varmagokul6/Golf-Ball-Launcher/Documentation/Propulsion Sketch - Gokul Varma.pdf

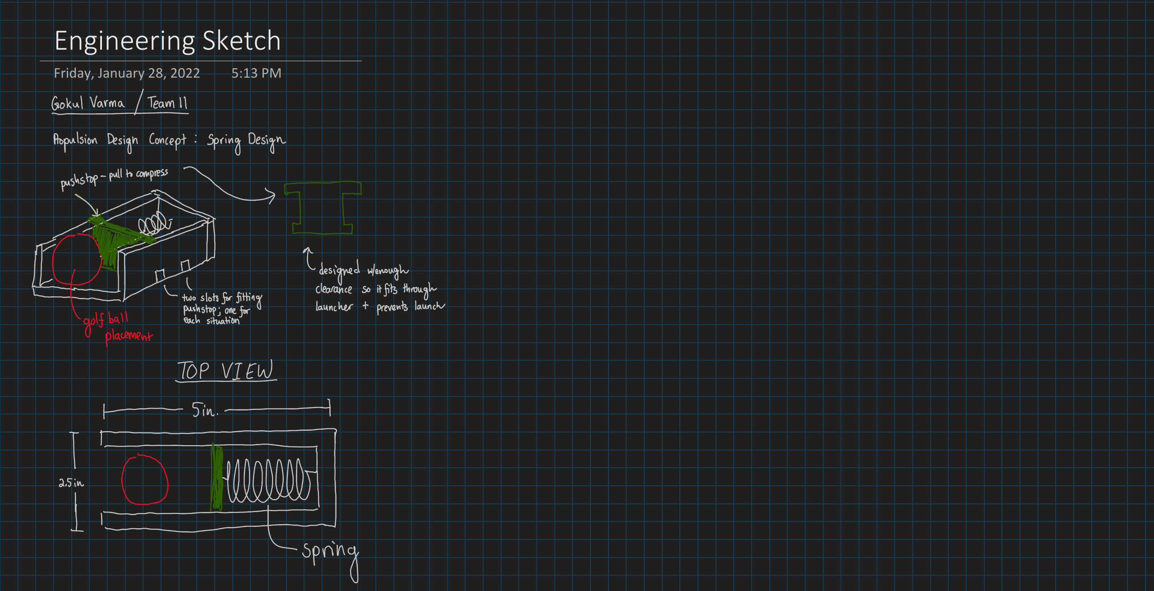
[picture p5: page 1]
