varmagokul6/Golf-Ball-Launcher/golf ball launcher.png

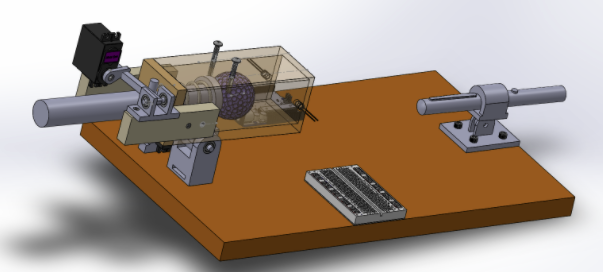
golf ball launcher.png
