varmagokul6/Golf-Ball-Launcher/images/finalprod.png

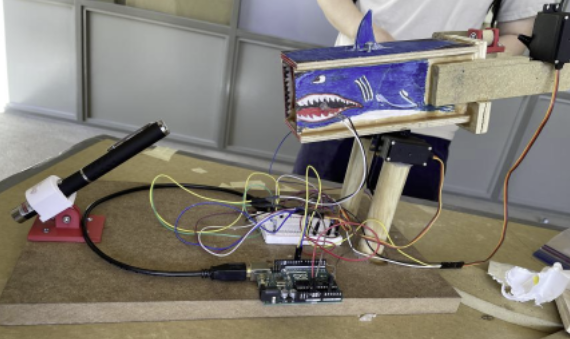
images/finalprod.png
