varmagokul6/Golf-Ball-Launcher/images/IMG_9626.jpg

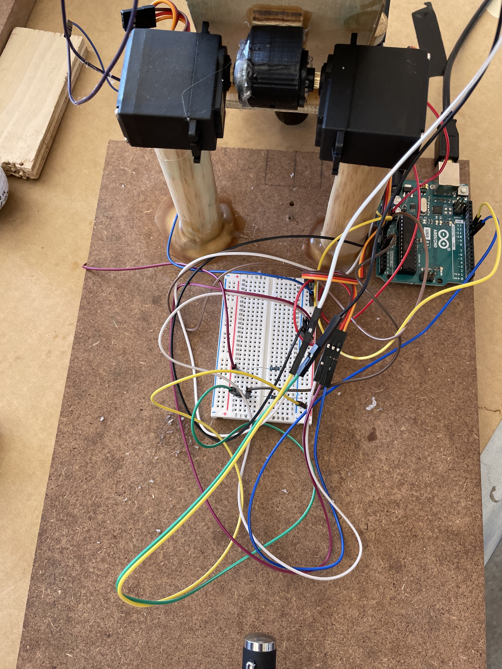
images/IMG_9626.jpg
