varmagokul6/Golf-Ball-Launcher/Documentation/Design Challenge_ Detailed Design Engineering Drawings and Manufacturing Files.pdf

## Detailed Design Engineering Drawings and Manufacturing Files

NOTE: All dimensions made in the engineering drawings are in inches unless stated otherwise

Pin:

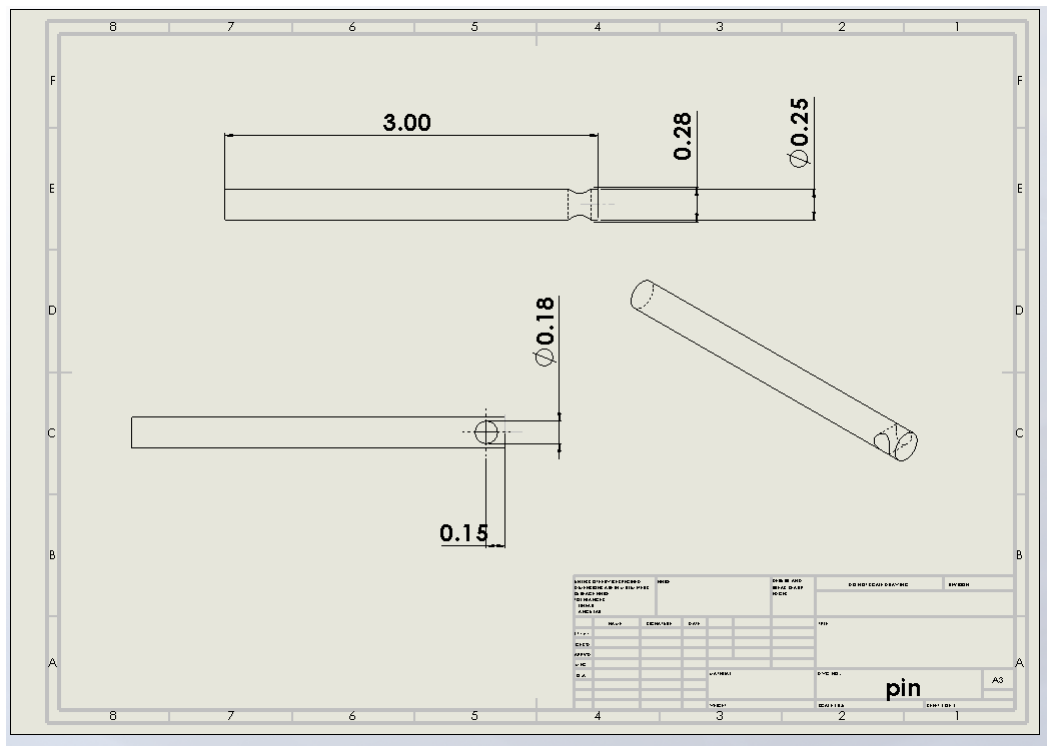
[picture p9: figure]

Pin Bearing:

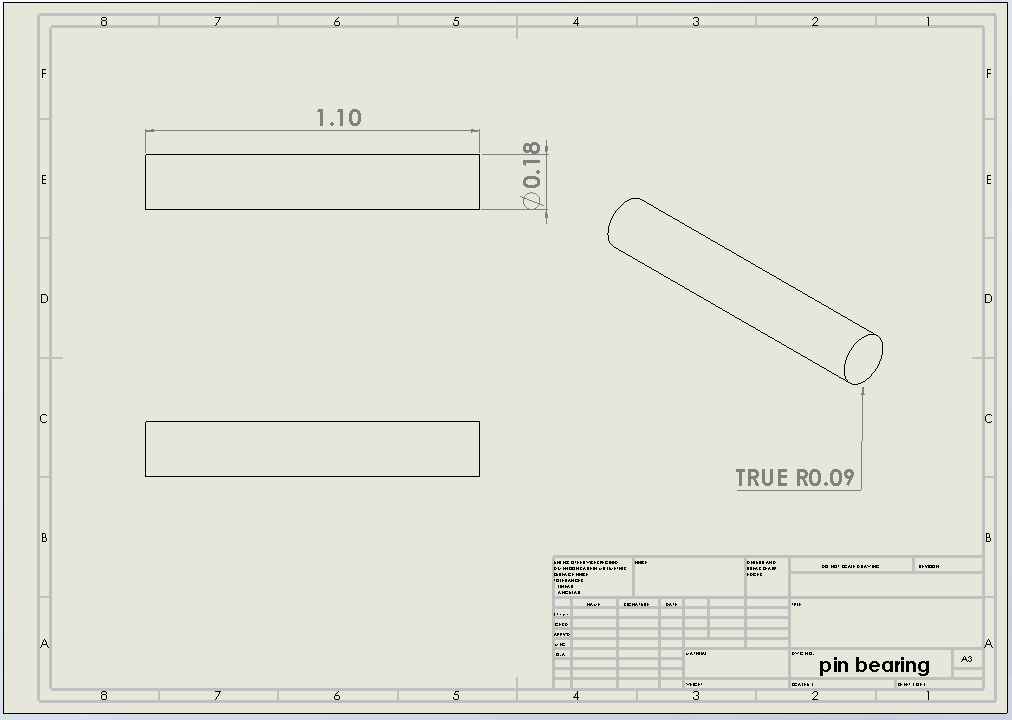
[picture p10: figure]

Plunger:

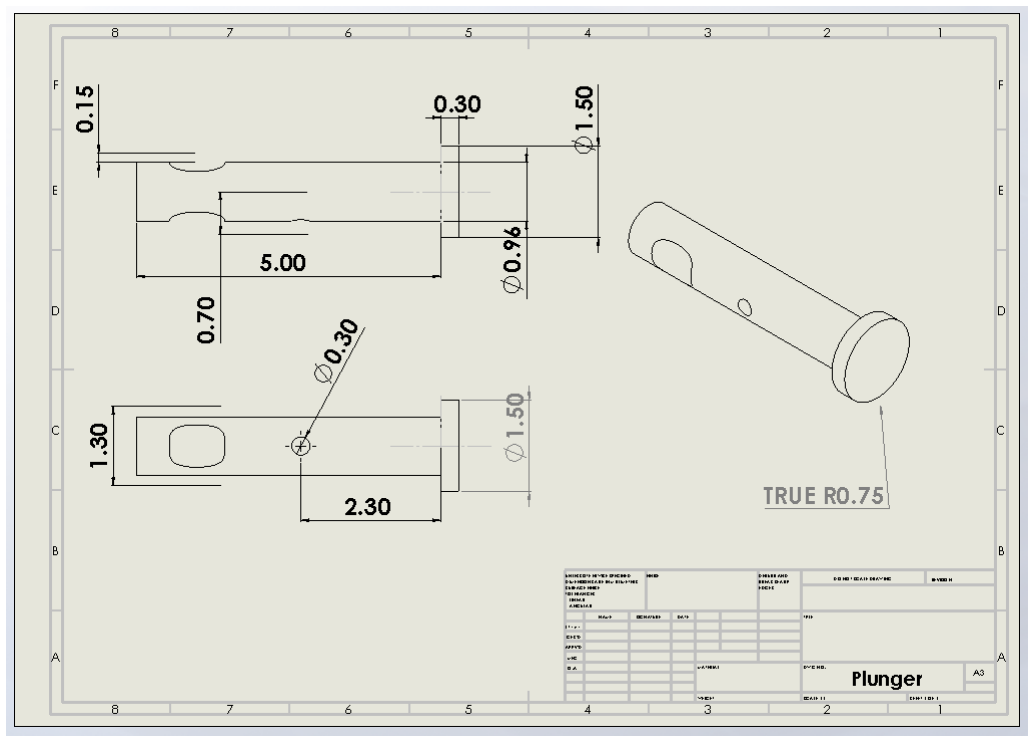
[picture p11: figure]

Plunger pin:

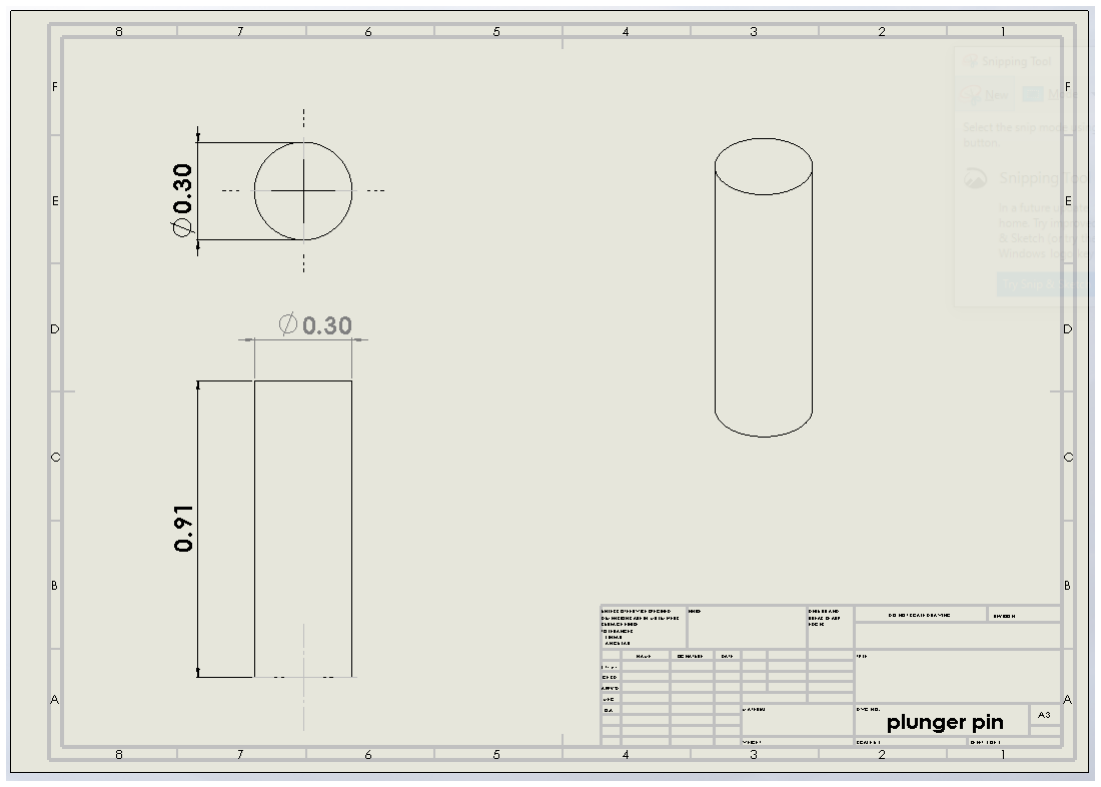
[picture p12: figure]

Laser Pivot:

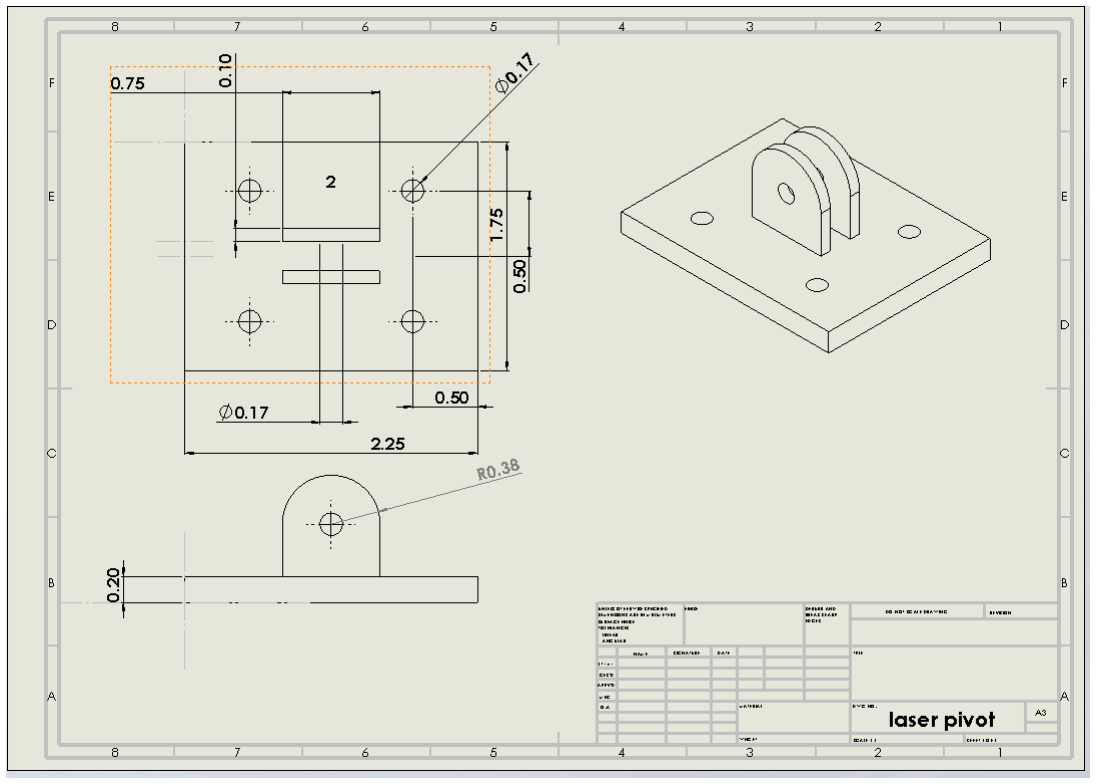
[picture p13: figure]

Laser Housing New 22:

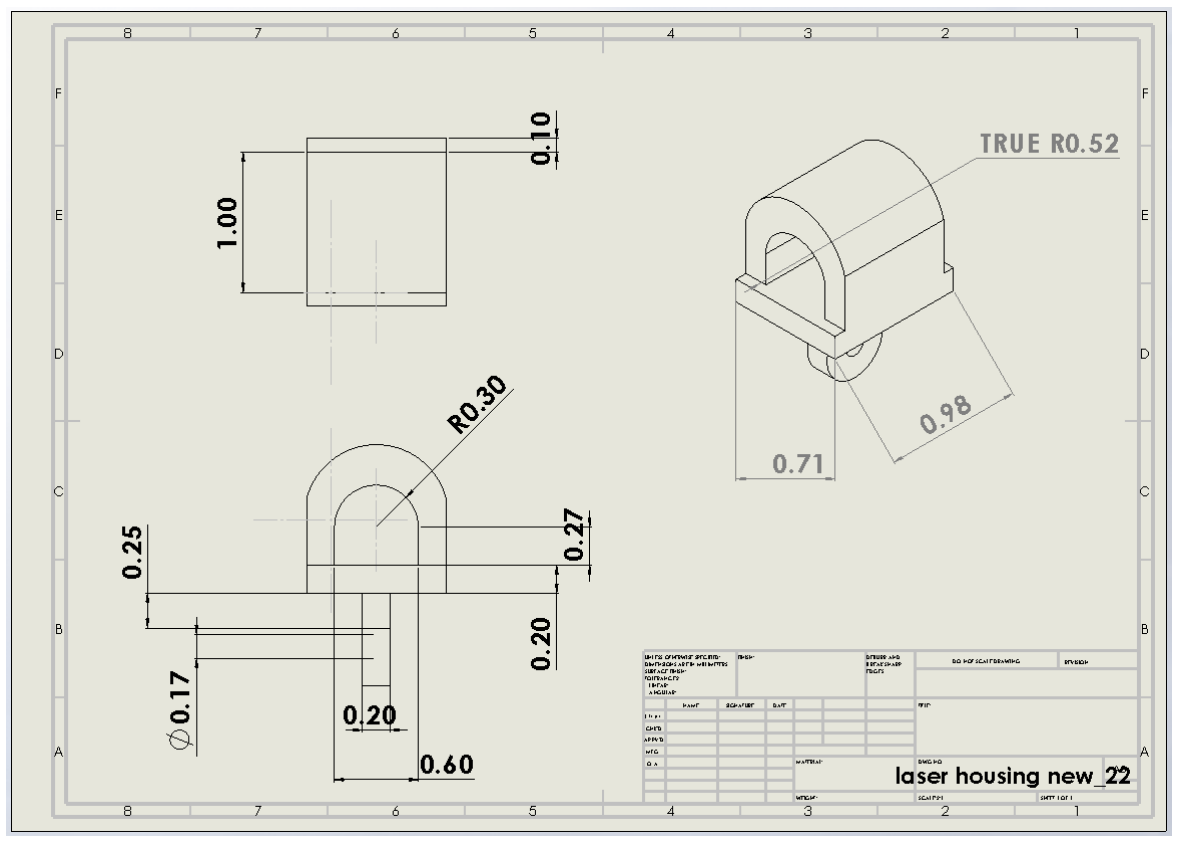
[picture p14: figure]

Base Pivot:

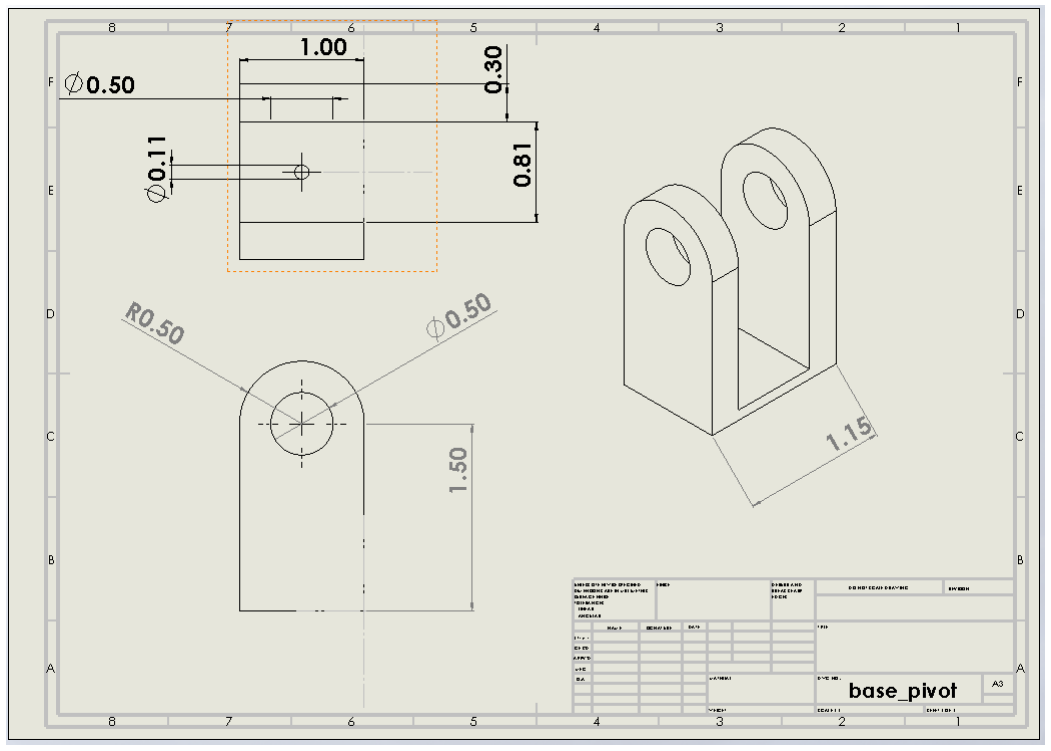
[picture p15: figure]

Servo Holder v2:

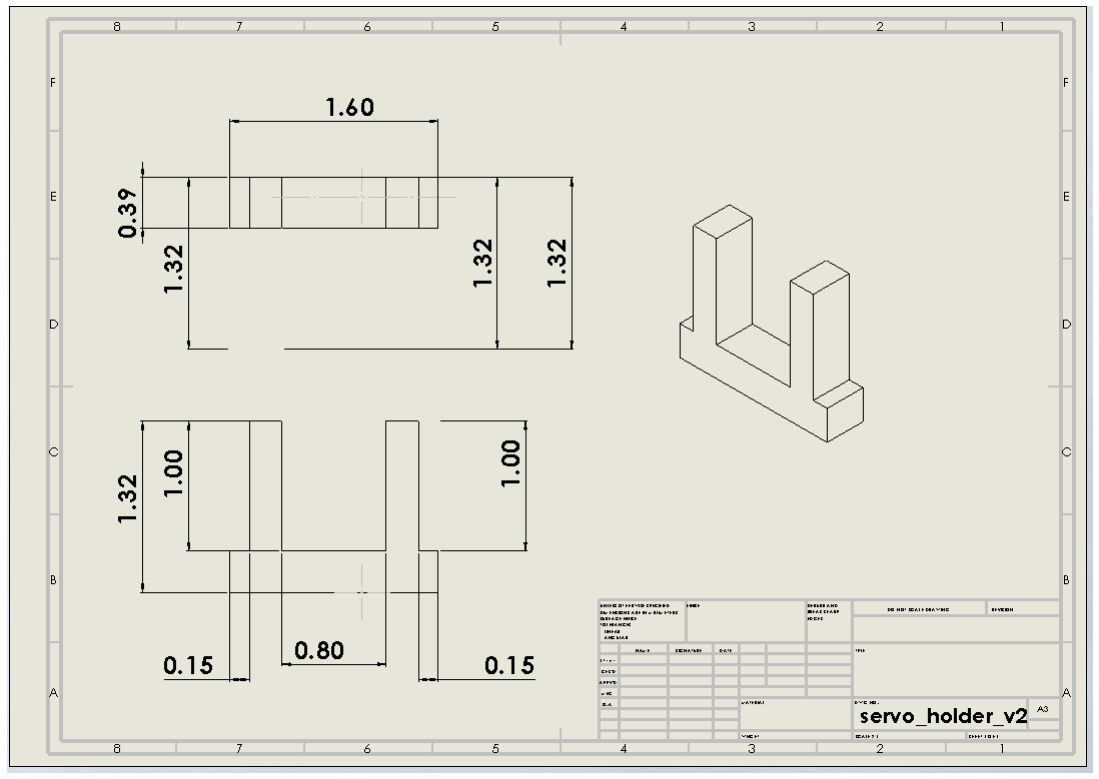
[picture p16: figure]

GBL Canister:

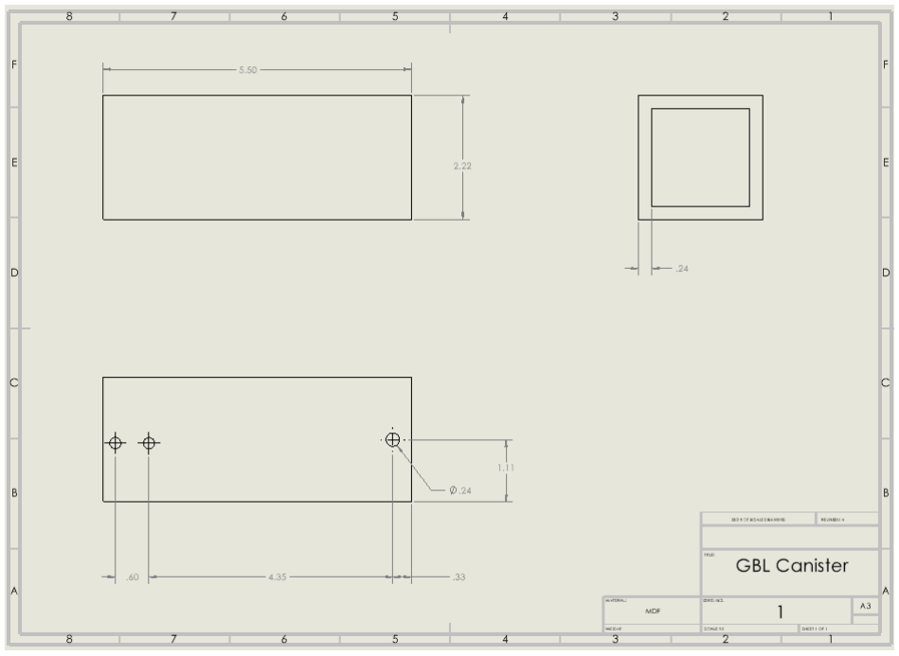
[picture p17: figure]

GBL Canister Backplate:

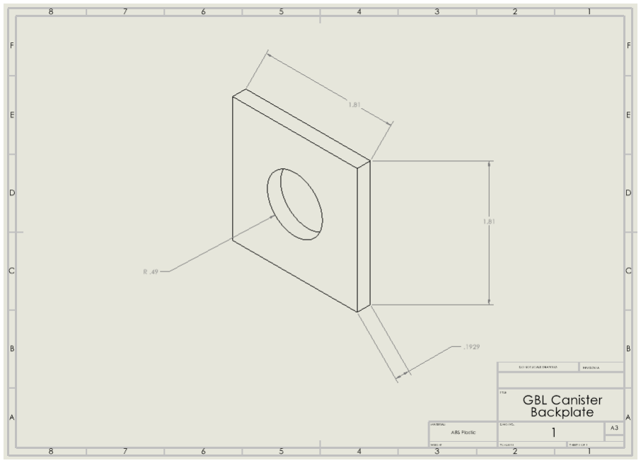
[picture p18: figure]

Angle Adjuster

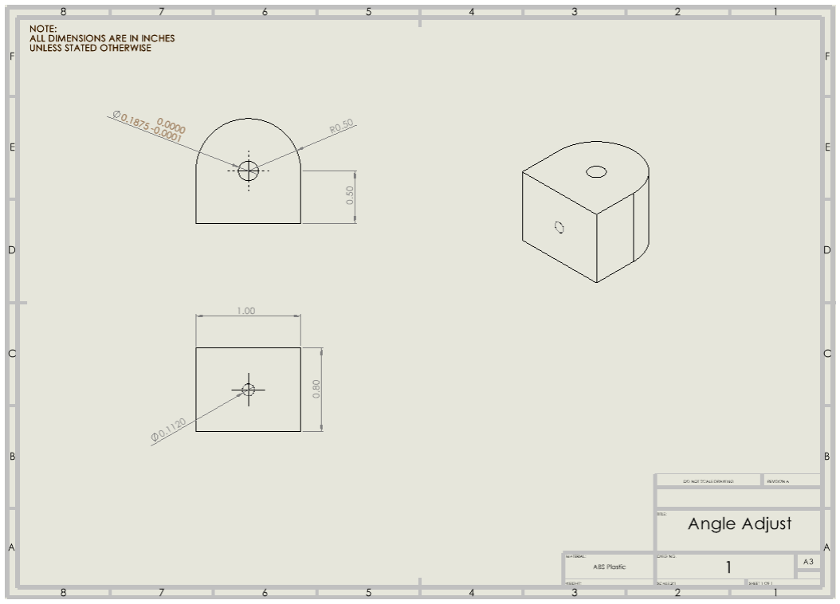
[picture p19: figure]

Bearing Base Plate

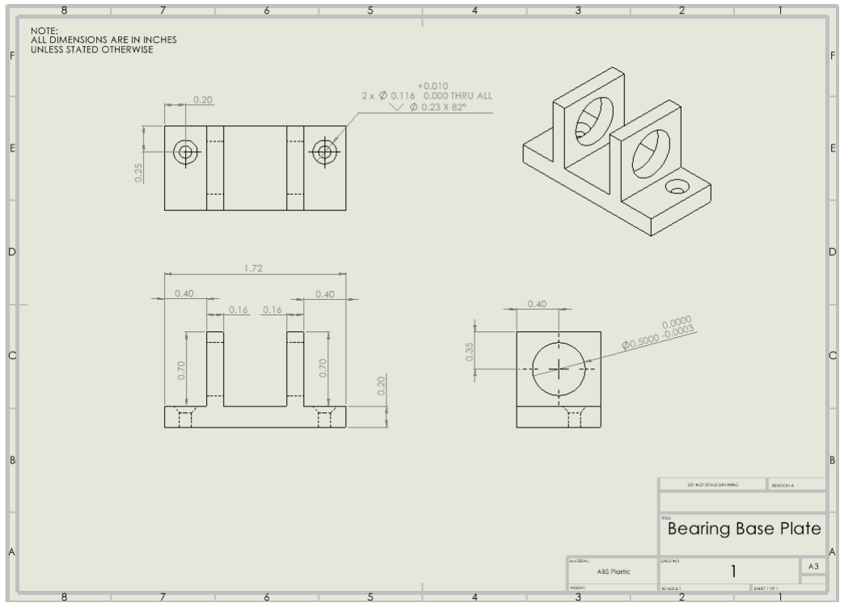
[picture p20: figure]

Pin Holder

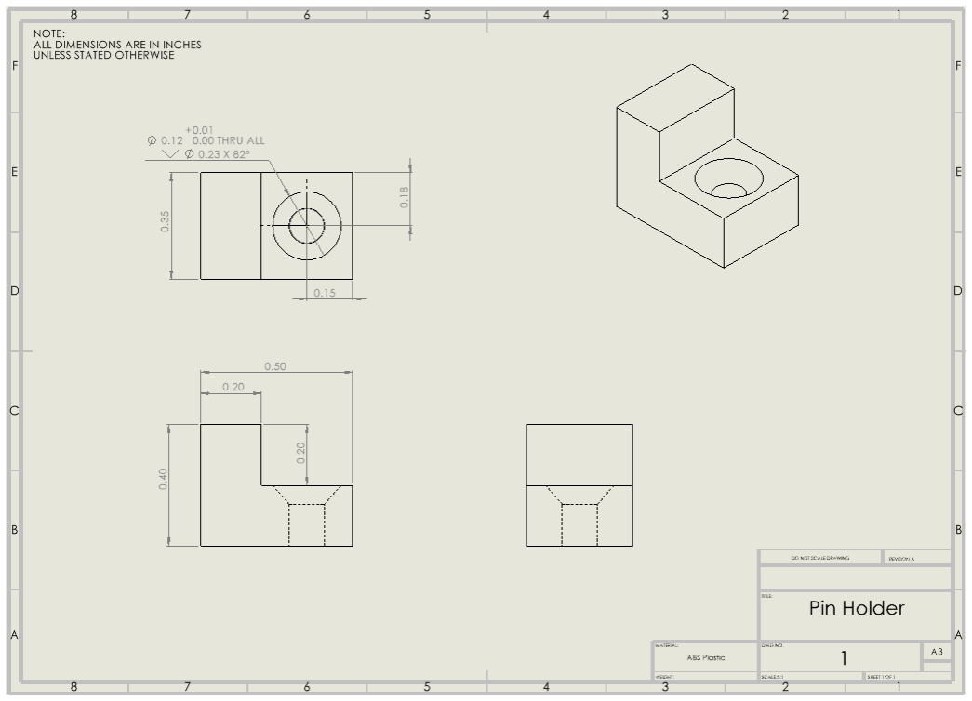
[picture p21: figure]

Rod

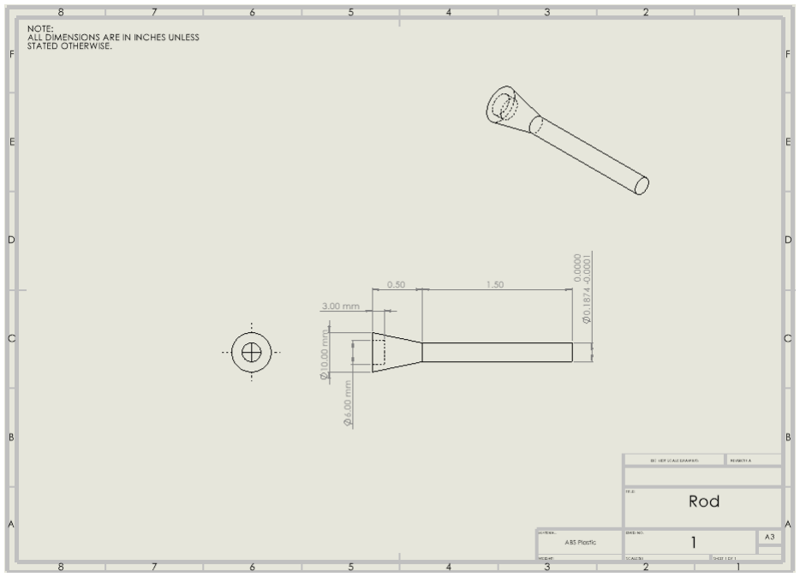
[picture p22: figure]
