varmagokul6/Golf-Ball-Launcher/images/GBL wiring diagram.png

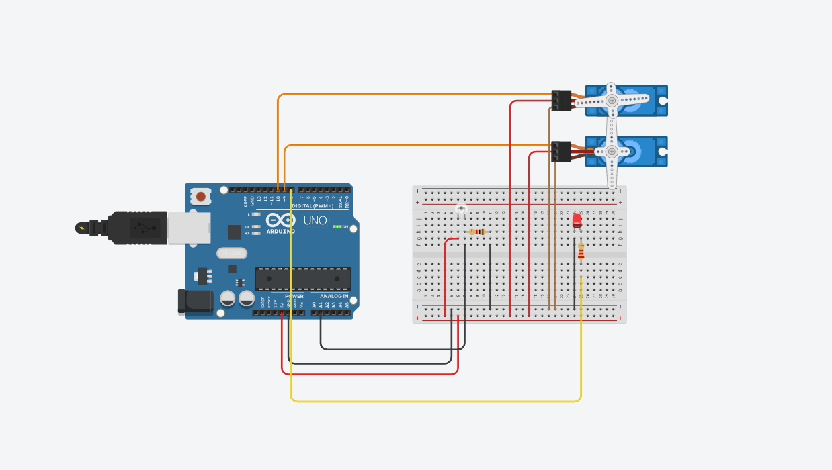
images/GBL wiring diagram.png
